NixVegas/pcb/(commit log)

2025-07-07 lustrate switch: use available footprint
    The one we were trying to use was a generic and not available on JLCPCB.
    [nixos.kicad_pcb, nixos.kicad_sch]
2025-07-07 kicad: fix power delivery and fab issues
    Accidentally used a N-channel MOSFET instead of a P-channel, which
    would've made the USB power switching on and off battery work backwards.
    Use a slightly bigger diode than 500 mA, 1A should be sufficient.
    Fix Nix store path to refer to fab output, and add board ID text.
    [nixos.kicad_pcb, nixos.kicad_sch]
2025-07-07 package: fix fab variable marking and rendering
    It was insufficient to just use jq to modify the kicad project. Package
    kicad-text-injector (simple rust project) to do it for us.
    Add renders while we're at it.
2025-07-07 silkscreen: reorganize team
    [nixos.kicad_pcb]
2025-07-13 badge: v0.8
    - Add microSD card
    - Add XO for real-time clock
    - Tune wire lengths for better signal integrity
    - Improve silkscreen
    [nixos.kicad_pcb, nixos.kicad_sch]
2025-07-13 silkscreen: show component designators
    [nixos.kicad_pcb]
2025-07-13 battery: replace footprint so we can have more shouts
    Open floor plan battery holder makes it easier for us to do shouts
    because people can actually see them.
    [nixos.kicad_pcb, nixos.kicad_sch]
2025-07-13 silkscreen: update graphics and J2 footprint
    Make the Distractions, Flox, and RISC-V logos more balanced. Add pinout
    to J2.
    [nixos.kicad_pcb]
2025-07-13 batteries: fix designator text thickness
    [nixos.kicad_pcb]
2025-07-13 schematic: organize
    The schematic now looks much nicer.
    [nixos.kicad_pcb, nixos.kicad_sch]
2025-07-17 badge: reroute button, encrypt colored silkscreen
    Attempt to compile a colored silkscreen into the build. Doesn't work
    just yet.
    [nixos.kicad_pcb, nixos.kicad_sch]
2025-07-17 badge: break out boot and status button into unique IOs
    We probably need to pull boot straight to ground per the Qwiic module
    schematic.
    [nixos.kicad_pcb, nixos.kicad_sch]
2025-07-17 badge: fix breakout silkscreen pin assignments
    [nixos.kicad_pcb]
2025-07-17 io2: connect to VSEL/2 voltage divider
    Let IO2 measure battery voltage (or VSEL). Use the same voltage divider
    SparkFun does on their Qwiic board.
    [nixos.kicad_pcb, nixos.kicad_sch]
2025-07-17 J3: move label
    [nixos.kicad_pcb]
2025-07-17 PWR/STAT: center a little better
    [nixos.kicad_pcb]
2025-07-17 STAT LED: we didn't have to put that resistor way over there
    [nixos.kicad_pcb]
2025-07-17 PWR/STAT resistors: clean up refs
    [nixos.kicad_pcb]
2025-07-19 regulator: eviscerate AMS1117 in favor of RT9080-33G75
    Avoid counterfeit parts by using the regulator that SparkFun recommends.
    [nixos.kicad_pcb, nixos.kicad_sch]
2025-07-20 art: make it look better
    svg2shenzhen with threshold 15 and 1500 dpi, plus some different Live
    Trace settings made it look way better.
2025-07-20 README: add badge pic and silkscreen info
2025-07-20 README: add PCB art DEF CON talk
